Guidoz1k/MadSynth/README.md

# ATTENTION
## This is a repo for a crunch project made for my graduation work. It was made in a absolute state of histeria. The quality of the code, mainly the AVR one, does not represent my coding skills. The ESP code is actually alright. The second version of the project, with much better documentation and code, a teensy 4.1 and MIDI communication, can be found [here](https://github.com/Guidoz1k/MadSynth2).

# MadSynth

 This is the repository for my synthesizer project. It's a personal project and also my bachelor's degree final work. The main goal of the project is the development of a low-cost, off-the-shelf parts based synthesizer using a jellybean microcontroller. The project is being logged in my youtube channel. Extra documentation can be found in the "docs" folder and code snippets can be accessed via links below.

 - [My youtube channel's "Addictive Synthesis" playlist ](https://www.youtube.com/watch?v=el0n1Baz8rg&list=PLg5_83tlBxnpsB1MY3rzBW0DkPemLgTyP&index=2)

 - [Bob Miller's Deep Synth](https://www.youtube.com/watch?v=wK5Sz6IzRqE)

 - [Dual-core ESP32 operation code](https://gist.github.com/9715aadec1a350504de06f6217da85a9.git)

The project was designed as follows:

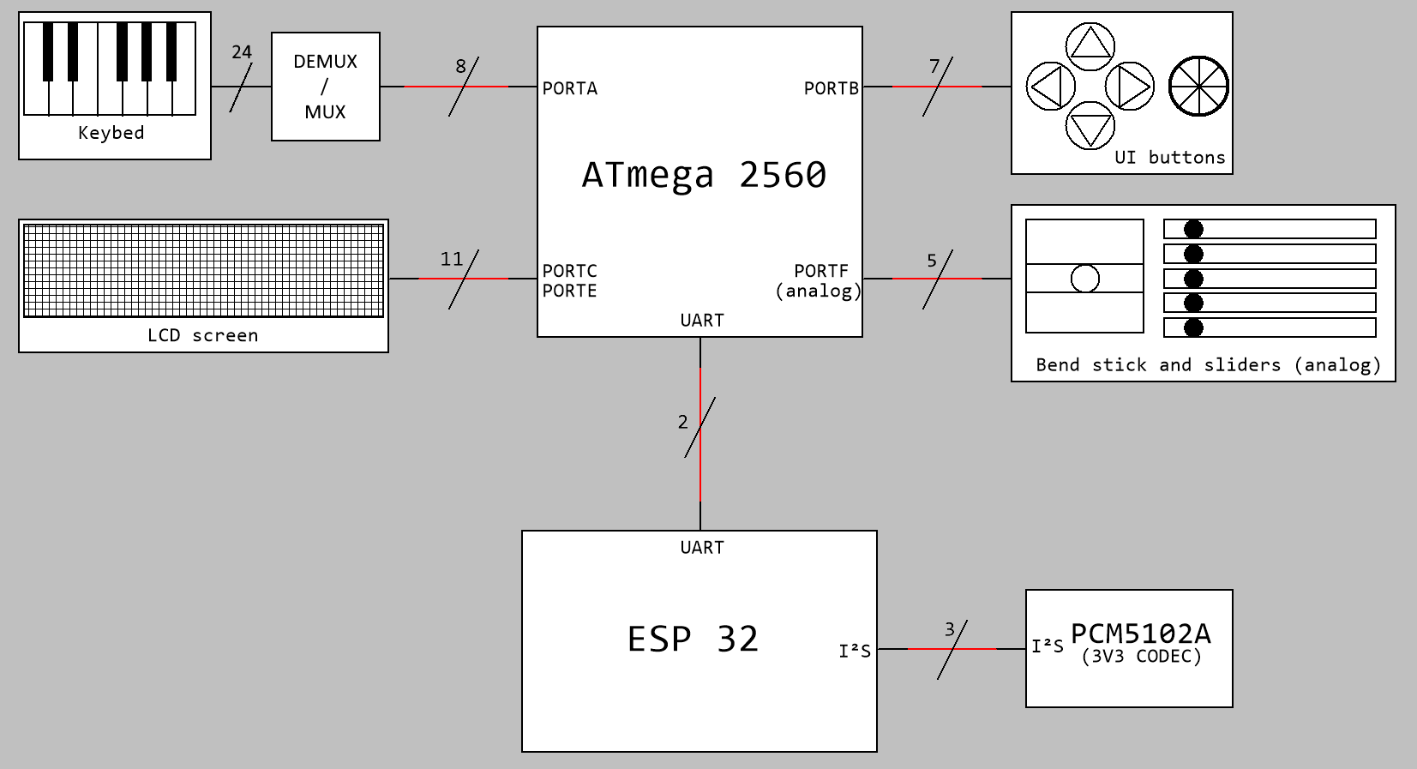
[picture p1: imgs/sch.png]


This is the final prototype:

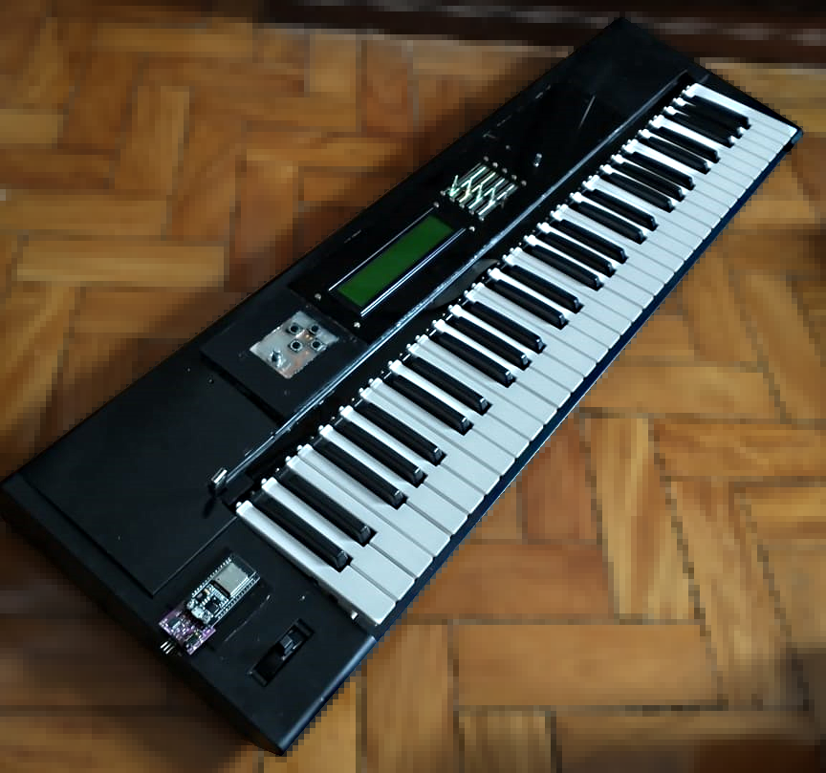
[picture p2: imgs/synth.png]


And this is its history:
First version          | Second version          | Third version           | Fourth version          | Fifth version
:-------------------------:|:-------------------------:|:-------------------------:|:-------------------------:|:-------------------------:|
[DUE] Sample based signal gen    | [ESP32] Deep Note project     |        [ESP32]                 | [STM32H743] Used in the MES course | [AVR/ESP] MadSynth's final version
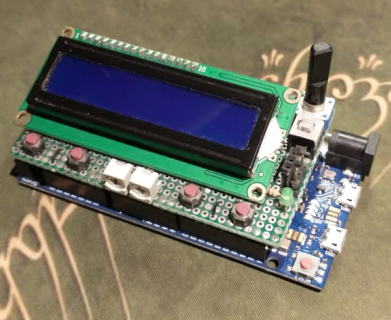
[picture p3: imgs/1.png]
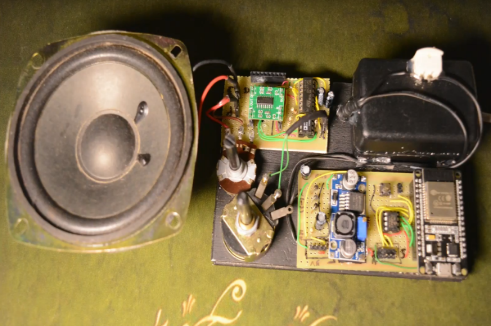
[picture p4: imgs/2.png]
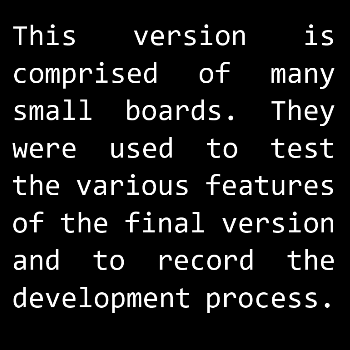
[picture p5: imgs/3.png]
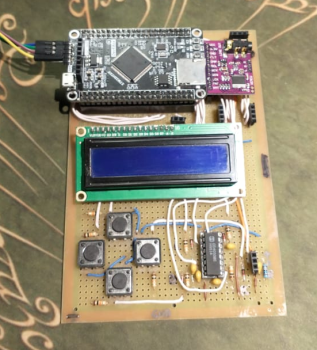
[picture p6: imgs/4.png]
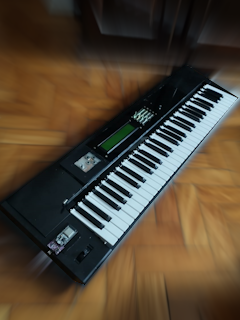
[picture p7: imgs/5.png]
 |  |  |  |
