Guidoz1k/MadSynth/(list of files, drawings)

Other design files:
Docs/Synth Archives/1st interation/CKTS/audio output.ms14
Docs/Synth Archives/1st interation/CKTS/powersource.ms14
Docs/Synth Archives/3rd iteration/simulations/filtro.ms14
Docs/Synth Archives/3rd iteration/simulations/fonte.ms14
Docs/Synth Archives/3rd iteration/simulations/ramp.ms14
Docs/Synth Archives/3rd iteration/simulations/VAC.ms14
Docs/Synth Archives/media/content sauce/ckt geral.ms14
