Guidoz1k/MadSynth/AVR/src/keyboard.c

#include "keyboard.h"
/*
    PORTA:
        0   Column pin 0
        1   Column pin 1
        2   Column pin 2
        3   Row pin 0
        4   Row pin 1
        5   Row pin 2
        6   Row pin 3
        7   Output pin
*/

void keyboard_init(void){
    DDRA = 0b01111111;
    PORTA = 0;
}

// sets the output to select the right mux channel
void keyboard_write(uint8_t position){
    // PORTA = column number | (Row number << 3); for more information check the "1 - keyboard layout.xlsx"
    switch(position){
    // first edge (x)
    // first octave, x edge
    case  0:
        PORTA = 4 | (6 << 3);
        break;
    case  1:
        PORTA = 5 | (6 << 3);
        break;
    case  2:
        PORTA = 6 | (6 << 3);
        break;
    case  3:
        PORTA = 7 | (6 << 3);
        break;
    case  4:
        PORTA = 0 | (5 << 3);
        break;
    case  5:
        PORTA = 1 | (5 << 3);
        break;
    case  6:
        PORTA = 2 | (5 << 3);
        break;
    case  7:
        PORTA = 3 | (5 << 3);
        break;
    case  8:
        PORTA = 4 | (5 << 3);
        break;
    case  9:
        PORTA = 5 | (5 << 3);
        break;
    case 10:
        PORTA = 6 | (5 << 3);
        break;
    case 11:
        PORTA = 7 | (5 << 3);
        break;
    // second octave, x edge
    case 12:
        PORTA = 0 | (4 << 3);
        break;
    case 13:
        PORTA = 1 | (4 << 3);
        break;
    case 14:
        PORTA = 2 | (4 << 3);
        break;
    case 15:
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
    __asm__("nop\n\t"); // delay for reading
    __asm__("nop\n\t"); // delay for reading
    __asm__("nop\n\t"); // delay for reading
}

// reads the output of the mux
uint8_t keyboard_read(void){
    uint8_t output = 0;

    if(PINA & 0b10000000)
        output = 1;

    return output;
}
