Guidoz1k/MadSynth/ESP/src/lut.c

#include "lut.h"

int16_t lut_sinuso[LUTSIZE] = {
     0,    102,    205,    308,    411,    514,    617,    720,    823,    926,   1029,   1132,   1234,   1337,   1440,   1543,   1646,   1749,   1851,   1954,
  2057,   2160,   2262,   2365,   2468,   2570,   2673,   2776,   2878,   2981,   3083,   3186,   3288,   3390,   3493,   3595,   3697,   3800,   3902,   4004,
  4106,   4208,   4310,   4412,   4514,   4616,   4718,   4820,   4922,   5024,   5125,   5227,   5329,   5430,   5532,   5633,   5734,   5836,   5937,   6038,
  6139,   6241,   6342,   6442,   6543,   6644,   6745,   6846,   6946,   7047,   7147,   7248,   7348,   7448,   7549,   7649,   7749,   7849,   7949,   8049,
  8148,   8248,   8348,   8447,   8546,   8646,   8745,   8844,   8943,   9042,   9141,   9240,   9339,   9437,   9536,   9634,   9733,   9831,   9929,  10027,
 10125,  10223,  10321,  10418,  10516,  10613,  10711,  10808,  10905,  11002,  11099,  11196,  11292,  11389,  11485,  11582,  11678,  11774,  11870,  11966,
 12062,  12157,  12253,  12348,  12444,  12539,  12634,  12729,  12824,  12918,  13013,  13107,  13202,  13296,  13390,  13484,  13577,  13671,  13764,  13858,
 13951,  14044,  14137,  14230,  14322,  14415,  14507,  14600,  14692,  14784,  14875,  14967,  15059,  15150,  15241,  15332,  15423,  15514,  15604,  15695,
 15785,  15875,  15965,  16055,  16145,  16234,  16324,  16413,  16502,  16591,  16679,  16768,  16856,  16944,  17032,  17120,  17208,  17295,  17383,  17470,
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
 20886,  20807,  20727,  20647,  20567,  20487,  20406,  20326,  20245,  20164,  20083,  20001,  19920,  19838,  19756,  19673,  19591,  19508,  19426,  19343,
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
};
