Guidoz1k/MadSynth/(commit log)

2022-03-07 update 2 onboard led
2022-03-07 update 3 timer functions are done, serial is only skeleton
2022-03-07 update 4 serial is operational, only kb functions are missing now
    [lcd.c, lcd.h, main.c, onboard.c, onboard.h, serial.c, serial.h, timer.c]
2022-03-13 skeleton for base low level code is done. keyboard excel added
    [1 - keyboard layout.xlsx]
2022-03-15 basic schematic
2022-03-20 minor corrections plus keyboard test
    [keyboard.c, keyboard.h, lcd.c, main.c, main.h, ui.c]
2022-03-20 keyboard machine state roughly done, last commit before board assembly
2022-03-25 adc corrected, still waiting for the new LCD, please kill me
    [1 - keyboard layout.xlsx]
2022-03-25 Final test version
    Analog read has now filtering, histeresis and binary division
    final version of the testing software
    all peripherals are OK
2022-03-29 inter chips uart prototype working
2022-04-26 AVR serial flood fix + many bug fixes
    [main.c, serial1.c, task.c]
2022-04-26 AVR adc remmap + minor bugfixes
    [anal.c, anal.h, main.c, serial1.c, serial1.h, task.c]
2022-04-27 DDS ENGINE = DONE! +lut_gen fixed
    [task.c]
2022-04-28 TEST VERSION. filter implemented. still needs work tho
2022-05-04 AVR 1.0, ESP32 to be finished
2022-05-11 controls implemented, only REVERB missing
    [main.c, serial1.c, task.c]
2024-02-23 legacy docs added, project closed
    [VAC.ms14, audio output.ms14, ckt geral.ms14, filtro.ms14, fonte.ms14, powersource.ms14, ramp.ms14]
2024-02-29 archival refactor
    [ckt geral.ms14]
